mfkiwl/xrpcam-hardware-zynq/hardware/zynq_board.kicad_pcb

## KiCad design hardware/zynq_board.kicad_pcb (2018-11-18)

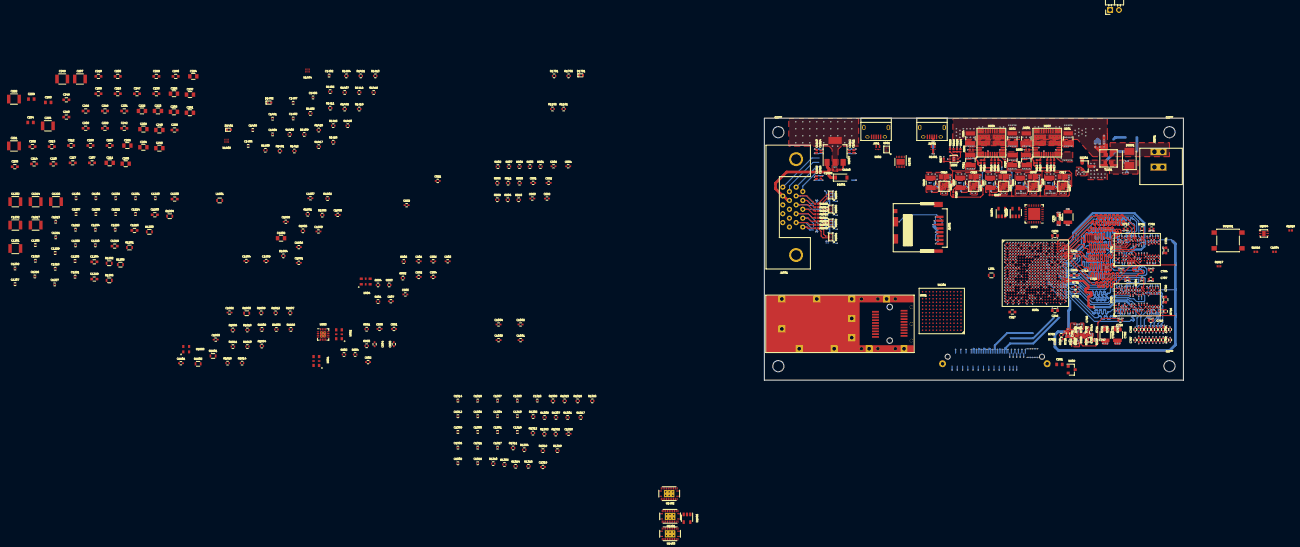
[picture p1: board zynq_board.kicad_pcb from above]

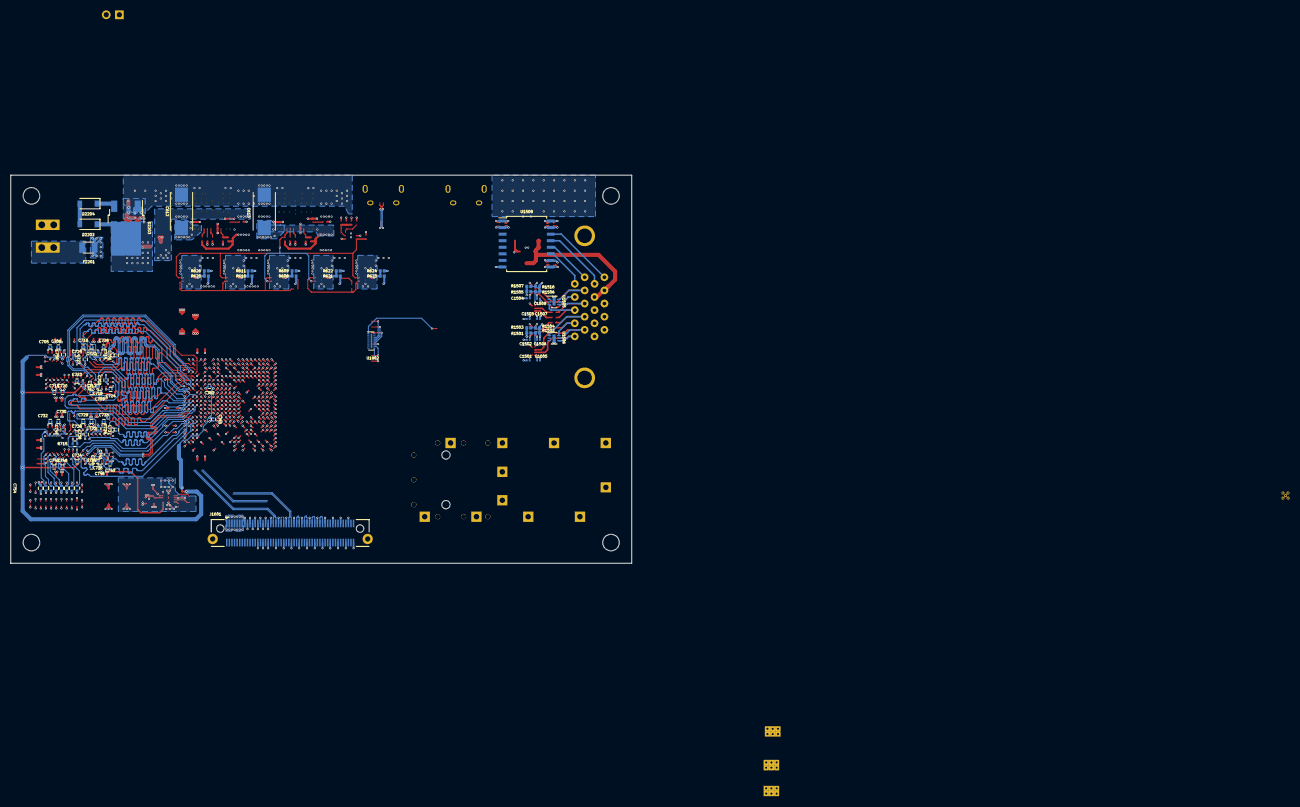
[picture p2: board zynq_board.kicad_pcb from below]

Board: 8 copper layers, 120.0 x 75.0 mm, 493 parts (86 on the bottom side), 429 nets.

Parts:
C201, C203, C234, C239: 47µF; C_0603_1608Metric
C204, C205, C206, C208, C211, C223, C224, C225, C226, C236, C237, C243, C245, C251, C256: 4.7µF; C_0805
C207, C221, C222, C232, C248, C254: 100µF; C_1210
C209, C210, C212, C213, C214, C215, C216, C217, C218, C219, C220, C227, C228, C229, C230, C231, C233, C235, C238, C240, C241, C242, C244, C246, C247, C249, C250, C252, C253, C257, C258: 0.47µF; C_0603
C255: 10μF; C_0603
C501, C502, C505, C506: 0.1uF; C_0402
C503, C504: 22uF; C_0402
C601, C602, C603, C604: 10uF 25V; C_1210_3225Metric
C605, C606, C615, C616, C617: 10uF; C_0805_2012Metric
C607, C608, C609, C618, C619, C620: 47uF 6.3V; C_1210_3225Metric
C610, C611: 100uF 6.3V; C_1210_3225Metric
C612, C613: 220uF 6.3V 15mΩ; C7343-31_KEMET-D_10.22x5.6mm
C614, C1804: 1nF; C_0402_1005Metric
C621, C622: 1 µF 6.3 V; C_0402
C701, C728: 10 µF; C_0603
C702, C704, C707, C710, C714, C717, C719, C722: 1µF; C_0402
C703, C705, C706, C708, C709, C711, C712, C713, C715, C716, C718, C720, C721, C723, C724, C725, C726, C727, C729, C730, C731, C732, C733, C734, C735, C736, C737, C738, C739, C740, C741, C742, C743, C744, C746, C748, C749, C1205, C1206, C1207, C1208, C1209, C1210, C1211, C1212, C1213, C1216, C1218, C1220, C1221, C1222, C1223, C1224, C1225, C1227, C1229, C1230, C1231, C1234, C1235, C1236, C1237, C1238, C1301, C1302, C1303, C1304, C1305, C1306, C1307, C1308, C1309, C1310, C1311, C1312, C1313, C1314, C1315, C1316, C1317, C1318, C1401, C1402, C1403, C1404, C1405, C1406, C1407, C1408: 100 nF; C_0201
C745, C756, C761, C762: 0.01µF; C_0201
C747, C750: 10µF; C_0603
C751: 0.22µF; C_0402
C752, C753, C1201, C1202, C1214, C1217, C1226, C1232: 100 µF; C_1210
C754, C755: 4,7 µF; C_0402
C757, C758, C759, C760: 10 nF; C_0201
C801, C802, C803, C804, C902, C904, C905, C906, C907: 100n; C_0402
C805: 1u; C_0402
C901, C903: 2u2; C_0402
C1001, C1002, C1003, C1004: C_Small; C_0402
C1203, C1204, C1215, C1219, C1228, C1233: 4,7 µF; C_0603
C1319, C1320: DNP; C_0402
C1501, C1502, C1503, C1504, C1505, C1506, C1507, C1508, C1512, C1514, C1515: 100 nF; C_0201_0603Metric
C1509, C1510, C1511, C1513, C1516: 1 µF 6,3 V; C_0402_1005Metric
C1801, C1802, C1803, C1904, C1907, C1908, C1909: 100 nF; C_0402
C1901, C1906: 10 nF; C_0402
C1902: 4,7 µF; C_0805
C1903, C1905: 47 pF; C_0402
D1401, D1402: LED_Small; LED_0402
D1501, D2204: PMEG3020EGWX; D_SOD-123
D1701: LED; LED_0402
D2201: P0220SCMCLRP; DO-214AA
D2202: 15 V; D_SOD-123
D2203: TN1515-600B-TR; TO-252-2
F2201: Fuse; Fuse_SMD1206_Reflow
J901, J1901: USB_OTG; USB_Micro-B
J1501: MDR20; Conn_MDR20
J1601: LSHM-150-xxx-x-DV-A-S
J1702: Conn_01x02; Pin_Header_Angled_1x02_Pitch2.54mm
J1801: DM3CS
J2201: Conn_01x02; WAGO-890-802
L201: 120 Ohm @ 1Mhz; L_0603
L1901: 600R@100MHz; L_0603
Q2201: DMP3056L; SOT-23
R501, R503, R504, R506, R507, R508, R509, R903, R1401, R1402, R1403, R1404, R1405, R1406, R1407, R1408, R1409, R1901: 10k; R_0402
R502, R505, R1301, R1303, R1305, R1307, R1309, R1313, R1317, R1701, R1804, R1807, R1809, R1810, R1812: DNP; R_0402
R510, R511, R904, R1418, R1419, R1420, R1421: 1k; R_0402
R601, R602, R603: 31.6k; R_0402_1005Metric
R604: 3.01k; R_0402_1005Metric
R605: 40.2k; R_0402_1005Metric
R606: 124k; R_0402_1005Metric
R607, R616, R617, R620, R627, R1819: 100k; R_0402_1005Metric
R608: 187k 1%; R_0402_1005Metric
R609, R611, R624: 150k 1%; R_0402_1005Metric
R610: 470k 1%; R_0402_1005Metric
R612, R614, R1501, R1503, R1506, R1516: 10k; R_0402_1005Metric
R613: 1.37k; R_0402_1005Metric
R615: 15k; R_0402_1005Metric
R618, R1817: 3M; R_0402_1005Metric
R619: 270k; R_0402_1005Metric
R621: 30k 1%; R_0402_1005Metric
R622: 120k 1%; R_0402_1005Metric
R623: 75k 1%; R_0402_1005Metric
R625: 68k 1%; R_0402_1005Metric
R626: 100k 1%; R_0402_1005Metric
R628: 43k; R_0402_1005Metric
R701, R704: 240Ω; R_0402
R702, R703: 10kΩ; R_0402
R705, R706, R707, R708, R709, R710, R711, R712, R713, R714, R717, R718, R719, R720, R721, R722, R723, R724, R725, R726, R727, R728, R729, R730: 40.2Ω; R_0402
R715, R731, R732: 80.6Ω; R_0402
R716: 4.7 kΩ; R_0402
R801, R802, R803, R901, R1302, R1304, R1306, R1308, R1310: 0; R_0402
R804, R1314: 100; R_0402
R902, R1904, R1905: 100k; R_0402
R905: 8.06k; R_0402
R1101, R1102: 4k7; R_0402
R1201, R1202, R1203, R1204, R1205, R1206: 0; R_0603
R1311, R1315, R1316, R1318, R1319, R1320: R; R_0402
R1312: 2k; R_0402
R1410, R1411: 420; R_0402
R1412, R1413, R1414, R1415: 300; R_0402
R1416, R1417: 200k; R_0402
R1502, R1504, R1505, R1507: DNP; R_0402_1005Metric
R1508, R1509, R1510, R1511, R1512, R1513, R1514, R1515: 270; R_0402_1005Metric
R1702: 430; R_0402
R1801: DNP; R_0603
R1802, R1803: 4k7; R_0603
R1805, R1806, R1808, R1811, R1813, R1814, R1815: 20k; R_0402
R1816: 40,2; R_0402
R1818: 560k; R_0402_1005Metric
R1902, R1903: 27; R_0402
SW1801: SW_Push; SW_SPST_PTS645
T2201: 500 Ohm@100 MHz; DLW5BTM_5.00x5.00mm
U201: xc7z030sbg485; SBG485_22x22_19.0x19.0mm_Pitch0.8mm
U501: SFPP_CONN; SFP+_Connector_with_Cage
U601, U602, U605, U606, U607: TPS8208x; TI_MicroSiP_2.9x3.1mm
U603, U604: TPSM84424; TI_QFM-24_MOL0024A
U608, U1804: TPS3808G01; Texas_S-PWSON-N6
U609: MCP1700-2502E_SOT23; SOT-23
U701, U703: MT41K128M8; BGA-96_2x3x16_9.0x13.0mm_Pitch0.8mm
U702: TPS51206; TI_PWSON-N10_2.0x2.0mm
U801, U802: DIFF_OSC; VDFN_3.2x2.5mm
U803: SI53340; QFN-16-1EP_3x3mm_Pitch0.5mm_ThermalVias
U901: NX5P3090; WLCSP12_3x4_1.35x1.65mm_Pitch0.4mm
U902, U1901: SMP1255PUTG; SMC_MicroDFN_1.8x2.0mm_0.4mm_Pitch
U903: USB3320; QFN-32-1EP_5x5mm_Pitch0.5mm
U904: OSC; VDFN_3.2x2.5mm
U1201: TLK10031; TI-CTR_FCBGA_N144_12x12_13x13mm_Pitch1.0mm
U1401, U1402, U1403: SN74AXC8T245; VQFN-24
U1404, U1405: LSF0102; TI-DQE_PX2SON-N8_1.4x1mm_0.35mm_Pitch
U1501, U1502, U1503, U1504: SN74LVC2T45; DSBGA_2x4_0.918x1.918mm_Pitch0.5mm
U1505, U1506: DMF05LCFLP; DFN-6-1EP_2x2mm_Pitch0.5mm
U1507: TC1262-33; SOT-223
U1508: MAX14854; SOIC-16W_7.5x10.3mm_Pitch1.27mm
U1801: CAT24C02TDI-GT3; SOT-23-5
U1802: EMIF06-MSD02N16; µQFN-16L
U1803: 33.333MHZ; ASDMB_2.5x2.0mm_1.65mm_pitch
U1902: FT234XD; DFN-12-1EP_3x3mm_Pitch0.45mm
U1903, U1904: SN74LV1T126; SOT-23-5

Connections:
+1V0: C205.1, C207.1, C208.1, C210.1, C211.1, C213.1, C215.1, C216.1, C218.1, C219.1, C220.1, C221.1, C224.1, C227.1, C230.1, C610.1, C611.1, C613.1, R614.1, R616.1, R1201.1, R1202.1, R1204.1, R1206.1, U201.G15, U201.H12, U201.H14, U201.J9, U201.J11, U201.J13, U201.J15, U201.K10, U201.L9, U201.L15, U201.M10, U201.N9, U201.N15, U201.P10, U201.R9, U201.R15, U604.1, U604.8
+1V0_MGT: C618.1, R620.1, R621.1, U201.U4, U201.U6, U201.U8, U201.W5, U201.W9, U605.8
+1V2_MGT: C619.1, R623.1, U201.AA2, U201.AA4, U201.AA8, U201.AB1, U201.AB6, U201.V7, U201.Y7, U606.8
+5V: C602.1, C604.1, C605.1, C606.1, C609.1, C612.1, C615.1, C616.1, C617.1, C749.1, C902.1, D1501.2, J1601.1, J1601.3, J1601.5, J1601.7, J1601.9, J1601.11, J1601.13, R612.1, R617.1, R618.1, R628.2, R702.2, R703.1, U601.3, U601.4, U602.3, U602.4, U603.1, U603.8, U604.11, U604.22, U605.3, U605.4, U606.3, U606.4, U607.3, U607.4, U608.1, U702.10, U901.B1, U901.B2, U901.C1
/10G Clock/125_00_MHZ_N: C1003.2, U801.5
/10G Clock/125_00_MHZ_P: C1004.2, U801.4
/10G Clock/156_25_MHZ_0_N: C1001.2, U803.10
/10G Clock/156_25_MHZ_0_P: C1002.2, U803.9
/10G Clock/156_25_MHZ_1_N: C1310.2, U803.12
/10G Clock/156_25_MHZ_1_P: C1305.2, U803.11
/BUTTON0: J1702.1, R1701.2, U201.D6
/Camera Connector/CAM_CLK_0_N: J1601.96, U201.Y15
/Camera Connector/CAM_CLK_0_P: J1601.98, U201.Y14
/Camera Connector/CAM_CLK_1_N: J1601.97, U201.Y19
/Camera Connector/CAM_CLK_1_P: J1601.99, U201.Y18
/Camera Connector/CAM_CTRL_0_N: J1601.36, U201.W16
/Camera Connector/CAM_CTRL_0_P: J1601.38, U201.V16
/Camera Connector/CAM_CTRL_1_N: J1601.63, U201.Y17
/Camera Connector/CAM_CTRL_1_P: J1601.61, U201.W17
/Camera Connector/D0_N: J1601.43, U201.V14
/Camera Connector/D0_P: J1601.45, U201.V13
/Camera Connector/D1_N: J1601.42, U201.W15
/Camera Connector/D1_P: J1601.44, U201.V15
/Camera Connector/D2_N: J1601.54, U201.W13
/Camera Connector/D2_P: J1601.56, U201.W12
/Camera Connector/D3_N: J1601.48, U201.W11
/Camera Connector/D3_P: J1601.50, U201.V11
/Camera Connector/D4_N: J1601.49, U201.U12
/Camera Connector/D4_P: J1601.51, U201.U11
/Camera Connector/D5_N: J1601.55, U201.AB11
/Camera Connector/D5_P: J1601.57, U201.AA11
/Camera Connector/D6_N: J1601.78, U201.AB12
/Camera Connector/D6_P: J1601.80, U201.AA12
/Camera Connector/D7_N: J1601.60, U201.AB14
/Camera Connector/D7_P: J1601.62, U201.AB13
/Camera Connector/D8_N: J1601.72, U201.Y13
/Camera Connector/D8_P: J1601.74, U201.Y12
/Camera Connector/D9_N: J1601.84, U201.AB22
/Camera Connector/D9_P: J1601.86, U201.AB21
/Camera Connector/D10_N: J1601.67, U201.AB19
/Camera Connector/D10_P: J1601.69, U201.AB18
/Camera Connector/D11_N: J1601.73, U201.AB17
/Camera Connector/D11_P: J1601.75, U201.AB16
/Camera Connector/D12_N: J1601.90, U201.AA20
/Camera Connector/D12_P: J1601.92, U201.AA19
/Camera Connector/D13_N: J1601.79, U201.V19
/Camera Connector/D13_P: J1601.81, U201.U19
/Camera Connector/D14_N: J1601.91, U201.W18
/Camera Connector/D14_P: J1601.93, U201.V18
/Camera Connector/D15_N: J1601.85, U201.U18
/Camera Connector/D15_P: J1601.87, U201.U17
/Camera Connector/FRAME_REQ_0: J1601.24, U1402.17
/Camera Connector/FRAME_REQ_1: J1601.18, U1402.20
/Camera Connector/LVDS_CLK0_N: J1601.39, U201.AA15
/Camera Connector/LVDS_CLK0_P: J1601.37, U201.AA14
/Camera Connector/LVDS_CLK1_N: J1601.66, U201.AA17
/Camera Connector/LVDS_CLK1_P: J1601.68, U201.AA16
/Camera Connector/T_EXP1_0: J1601.22, U1402.18
/Camera Connector/T_EXP1_1: J1601.16, U1402.21
/Camera Connector/T_EXP2_0: J1601.20, U1402.19
/Camera Connector/T_EXP2_1: J1601.14, U1401.14
/DDR/A0: R724.2, U201.M19, U701.N3, U703.N3
/DDR/A1: R711.2, U201.M18, U701.P7, U703.P7
/DDR/A2: R723.2, U201.K19, U701.P3, U703.P3
/DDR/A3: R710.2, U201.L19, U701.N2, U703.N2
/DDR/A4: R722.2, U201.K17, U701.P8, U703.P8
/DDR/A5: R709.2, U201.K18, U701.P2, U703.P2
/DDR/A6: R721.2, U201.J16, U701.R8, U703.R8
/DDR/A7: R708.2, U201.J17, U701.R2, U703.R2
/DDR/A8: R720.2, U201.J18, U701.T8, U703.T8
/DDR/A9: R707.2, U201.H18, U701.R3, U703.R3
/DDR/A10: R719.2, U201.J20, U701.L7, U703.L7
/DDR/A11: R706.2, U201.G18, U701.R7, U703.R7
/DDR/A12: R718.2, U201.H19, U701.N7, U703.N7
/DDR/A13: R705.2, U201.F19, U701.T3, U703.T3
/DDR/A14: R717.2, U201.G19, U701.T7, U703.T7
/DDR/DDR_BA0: R730.2, U201.L16, U701.M2, U703.M2
/DDR/DDR_BA1: R714.2, U201.L17, U701.N8, U703.N8
/DDR/DDR_BA2: R729.2, U201.M17, U701.M3, U703.M3
/DDR/DDR_CKE: R727.2, U201.T19, U701.K9, U703.K9
/DDR/DDR_CLK_N: R715.1, U201.N18, U701.K7, U703.K7
/DDR/DDR_CLK_P: R715.2, U201.N19, U701.J7, U703.J7
/DDR/DDR_DM0: U201.B22, U701.E7
/DDR/DDR_DM1: U201.H20, U701.D3
/DDR/DDR_DM2: U201.P22, U703.E7
/DDR/DDR_DM3: U201.AA21, U703.D3
/DDR/DDR_DQS0_N: U201.D21, U701.G3
/DDR/DDR_DQS0_P: U201.C21, U701.F3
/DDR/DDR_DQS1_N: U201.J21, U701.B7
/DDR/DDR_DQS1_P: U201.H21, U701.C7
/DDR/DDR_DQS2_N: U201.P21, U703.G3
/DDR/DDR_DQS2_P: U201.N21, U703.F3
/DDR/DDR_DQS3_N: U201.W21, U703.B7
/DDR/DDR_DQS3_P: U201.V21, U703.C7
/DDR/DDR_ODT: R728.2, U201.P18, U701.K1, U703.K1
/DDR/DQ0: U201.D22, U701.H7
/DDR/DQ1: U201.C20, U701.F7
/DDR/DQ2: U201.B21, U701.F8
/DDR/DQ3: U201.D20, U701.H8
/DDR/DQ4: U201.E20, U701.H3
/DDR/DQ5: U201.E22, U701.E3
/DDR/DQ6: U201.F21, U701.F2
/DDR/DQ7: U201.F22, U701.G2
/DDR/DQ8: U201.G21, U701.D7
/DDR/DQ9: U201.G22, U701.B8
/DDR/DQ10: U201.L22, U701.A3
/DDR/DQ11: U201.L21, U701.A2
/DDR/DQ12: U201.L20, U701.C3
/DDR/DQ13: U201.K22, U701.C2
/DDR/DQ14: U201.J22, U701.A7
/DDR/DQ15: U201.K20, U701.C8
/DDR/DQ16: U201.M22, U703.H8
/DDR/DQ17: U201.T20, U703.H3
/DDR/DQ18: U201.N20, U703.F8
/DDR/DQ19: U201.T22, U703.E3
/DDR/DQ20: U201.R20, U703.G2
/DDR/DQ21: U201.T21, U703.F2
/DDR/DQ22: U201.M21, U703.F7
/DDR/DQ23: U201.R22, U703.H7
/DDR/DQ24: U201.Y20, U703.C2
/DDR/DQ25: U201.U22, U703.D7
/DDR/DQ26: U201.AA22, U703.C3
/DDR/DQ27: U201.U21, U703.B8
/DDR/DQ28: U201.W22, U703.A7
/DDR/DQ29: U201.W20, U703.A3
/DDR/DQ30: U201.V20, U703.C8
/DDR/DQ31: U201.Y22, U703.A2
/DDR/VREF: C745.1, C751.1, C756.1, C761.1, C762.1, U201.H16, U201.P16, U701.H1, U701.M8, U702.6, U703.H1, U703.M8
/DDR/VTT: C750.2, C752.1, C753.1, C754.1, C755.1, C757.1, C758.1, C759.1, C760.1, R705.1, R706.1, R707.1, R708.1, R709.1, R710.1, R711.1, R712.1, R713.1, R714.1, R717.1, R718.1, R719.1, R720.1, R721.1, R722.1, R723.1, R724.1, R725.1, R726.1, R727.1, R728.1, R729.1, R730.1, U702.3, U702.5
/DDR/~DDR_CAS~: R725.2, U201.P20, U701.K3, U703.K3
/DDR/~DDR_CS~: R726.2, U201.P17, U701.L2, U703.L2
/DDR/~DDR_RAS~: R713.2, U201.R18, U701.J3, U703.J3
/DDR/~DDR_RESET~: R716.2, U201.F20, U701.T2, U703.T2
/DDR/~DDR_WE~: R712.2, U201.R19, U701.L3, U703.L3
/IMU_CLK: J1601.19, U201.A7
/IMU_EN_0: J1601.17, U201.B7
/IMU_EN_1: J1601.15, U201.B8
/IMU_FRAME_GPIO0: J1601.25, U201.J5
/IMU_INT1_GPIO1: J1601.27, U201.K5
/IMU_INT2_GPIO2: J1601.29, U201.L5
/IMU_MISO: J1601.23, U201.A6
/IMU_MOSI: J1601.21, U201.B6
/LED1: U201.E8, U1402.8
/LED2: U201.E7, U1402.9
/LS_OK_IN_A: U201.N1, U1201.B10
/LS_OK_OUT_A: U201.P1, U1201.D9
/Levelshifters/CAM0_CLK_REF: J1601.32, U1401.20
/Levelshifters/CAM1_CLK_REF: J1601.28, U1401.21
/Levelshifters/CAM_CLK0_REF_18: U201.B4, U1401.4
/Levelshifters/CAM_CLK1_REF_18: U201.D5, U1401.3
/Levelshifters/CAM_RESET: J1601.2, U1401.19
/Levelshifters/CAM_RESET_18: U201.B3, U1401.5
/Levelshifters/CAM_SCL: J1601.31, R1421.2, U1405.6
/Levelshifters/CAM_SCL_18: R1413.2, U201.A5, U1405.3
/Levelshifters/CAM_SDA: J1601.33, R1419.2, U1405.5
/Levelshifters/CAM_SDA_18: R1415.2, U201.A4, U1405.4
/Levelshifters/CAM_SPI_CLK: J1601.4, U1401.16
/Levelshifters/CAM_SPI_CLK_18: U201.C3, U1401.8
/Levelshifters/CAM_SPI_EN_0: J1601.8, U1401.17
/Levelshifters/CAM_SPI_EN_0_18: U201.A2, U1401.7
/Levelshifters/CAM_SPI_EN_1: J1601.6, U1401.18
/Levelshifters/CAM_SPI_EN_1_18: U201.B2, U1401.6
/Levelshifters/CAM_SPI_MISO: J1601.10, U1403.21
/Levelshifters/CAM_SPI_MISO_18: U201.B1, U1403.3
/Levelshifters/CAM_SPI_MOSI: J1601.12, U1401.15
/Levelshifters/CAM_SPI_MOSI_18: U201.A1, U1401.9
/Levelshifters/FRAME_REQ_0_18: U201.F1, U1402.7
/Levelshifters/FRAME_REQ_1_18: U201.D1, U1402.4
/Levelshifters/MODDET_18: U201.K2, U1403.6
/Levelshifters/RX_LOS_18: U201.J2, U1403.4
/Levelshifters/SFP_GPIO_18: U201.J1, U1403.7
/Levelshifters/SFP_SCL_18: R1412.2, U201.L1, U1404.3
/Levelshifters/SFP_SDA_18: R1414.2, U201.L2, U1404.4
/Levelshifters/TX_DISABLE_18: U201.M1, U1403.8
/Levelshifters/TX_FAULT_18: U201.M2, U1403.5
/Levelshifters/T_EXP1_0_18: U201.E2, U1402.6
/Levelshifters/T_EXP1_1_18: U201.D2, U1402.3
/Levelshifters/T_EXP2_0_18: U201.D3, U1402.5
/Levelshifters/T_EXP2_1_18: U201.C1, U1401.10
/MDC: U201.T1, U1201.J8
/MDIO: R1312.1, U201.T2, U1201.J7
/MODDET: R506.2, U501.6, U1403.18
/PG: R627.2, R1817.1, U201.B18, U602.2, U606.2, U607.2, U608.6
/PL: Bank 34/DE: U201.M3, U1508.6
/PL: Bank 34/RXD: U201.P3, U1508.3
/PL: Bank 34/TXD: U201.K3, U1508.5
/PL: Bank 34/~RE~: U201.N3, U1508.4
/PL: Bank 34/~SBA~: U201.J3, U1508.7
/PL: MGT/MGTX_RX_0_N: C1318.2, U201.AB7
/PL: MGT/MGTX_RX_0_P: C1314.2, U201.AA7
/PL: MGT/MGTX_RX_1_N: C1309.2, U201.Y8
/PL: MGT/MGTX_RX_1_P: C1304.2, U201.W8
/PL: MGT/MGTX_RX_2_N: C1317.2, U201.AB9
/PL: MGT/MGTX_RX_2_P: C1313.2, U201.AA9
/PL: MGT/MGTX_RX_3_N: C1308.2, U201.Y6
/PL: MGT/MGTX_RX_3_P: C1303.2, U201.W6
/PMIC/EN_1V0_MGT: R616.2, U601.1, U604.7, U605.1
/PMIC/EN_1V2_MGT: R620.2, U605.2, U606.1
/PMIC/EN_3V3: R607.2, U601.2, U602.1, U607.1
/PMIC/PG_5V: R617.2, U603.7, U604.10
/PRBSEN: U201.P2, U1201.B9
/Power/VCC_PLL: C255.1, C258.1, L201.2, U201.G13
/Processing System IO/BOOT_MODE[0]: R1806.2, R1807.1, U201.A20
/Processing System IO/BOOT_MODE[1]: R1810.2, R1811.1, U201.F17
/Processing System IO/BOOT_MODE[2]: R1808.2, R1809.1, U201.E19
/Processing System IO/BOOT_MODE[3]: R1812.2, R1813.1, U201.A21
/Processing System IO/BOOT_MODE[4]: R1804.2, R1805.1, U201.A19
/Processing System IO/CLK_33.33: R1816.2, U201.F16
/Processing System IO/PS_RESET: R1819.2, U201.C14, U1804.6
/Processing System IO/SCL: R1803.2, U201.A9, U1801.1
/Processing System IO/SDA: R1802.2, U201.E12, U1801.3
/Processing System IO/SDIO0_CD: J1801.9, U201.D11, U1802.1
/Processing System IO/SDIO0_CK: U201.E9, U1802.6
/Processing System IO/SDIO0_CMD: U201.C15, U1802.5
/Processing System IO/SDIO0_IO0: U201.D15, U1802.7
/Processing System IO/SDIO0_IO1: U201.B12, U1802.8
/Processing System IO/SDIO0_IO2: U201.E10, U1802.3
/Processing System IO/SDIO0_IO3: U201.B14, U1802.4
/Processing System IO/VMODE_0: R1814.1, U201.D18
/Processing System IO/VMODE_1: R1815.1, U201.E18
/RX_LOS: R503.2, U501.8, U1403.20
/SFP_GPIO: R510.1, R511.1, U1403.17
/SFP_SCL: R507.2, R1420.2, U501.5, U1404.6
/SFP_SDA: R508.2, R1418.2, U501.4, U1404.5
/ST: U201.R2, U1201.M9
/TLK10031 Power/DVDD: C1217.1, C1219.1, C1221.1, C1223.1, C1224.1, C1225.1, C1227.1, C1229.1, R1204.2, U1201.D7, U1201.E7, U1201.F7, U1201.G6, U1201.G8, U1201.H7
/TLK10031 Power/VDDA: C1201.1, C1203.1, C1205.1, C1207.1, C1209.1, C1211.1, C1212.1, C1213.1, R1201.2, U1201.D2, U1201.F2, U1201.F11, U1201.G2, U1201.G10, U1201.J2
/TLK10031 Power/VDDD: C1232.1, C1233.1, C1234.1, C1235.1, C1236.1, C1237.1, C1238.1, R1206.2, U1201.E6, U1201.E8, U1201.F6, U1201.H6, U1201.H8
/TLK10031 Power/VDDO: C1226.1, C1228.1, C1230.1, C1231.1, R1205.2, U1201.C7, U1201.K7
/TLK10031 Power/VDDRA: C1214.1, C1215.1, C1216.1, C1218.1, C1220.1, C1222.1, R1203.2, U1201.C3, U1201.E11, U1201.J11, U1201.K3
/TLK10031 Power/VDDT: C1202.1, C1204.1, C1206.1, C1208.1, C1210.1, R1202.2, U1201.F4, U1201.F9, U1201.G4
/TLK10031/HSRXA_N: U501.12, U1201.A12
/TLK10031/HSRXA_P: U501.13, U1201.B12
/TLK10031/HSTXA_N: U501.19, U1201.E12
/TLK10031/HSTXA_P: U501.18, U1201.D12
/TLK10031/INA0_N: C1316.1, U1201.A3
/TLK10031/INA0_P: C1312.1, U1201.A4
/TLK10031/INA1_N: C1307.1, U1201.B1
/TLK10031/INA1_P: C1302.1, U1201.A1
/TLK10031/INA2_N: C1315.1, U1201.C2
/TLK10031/INA2_P: C1311.1, U1201.B2
/TLK10031/INA3_N: C1306.1, U1201.E1
/TLK10031/INA3_P: C1301.1, U1201.D1
/TLK10031/INA[0]_N: C1316.2, U201.AB3
/TLK10031/INA[0]_P: C1312.2, U201.AA3
/TLK10031/INA[1]_N: C1307.2, U201.Y4
/TLK10031/INA[1]_P: C1302.2, U201.W4
/TLK10031/INA[2]_N: C1315.2, U201.AB5
/TLK10031/INA[2]_P: C1311.2, U201.AA5
/TLK10031/INA[3]_N: C1306.2, U201.Y2
/TLK10031/INA[3]_P: C1301.2, U201.W2
/TLK10031/OUTA0_N: C1318.1, U1201.A7
/TLK10031/OUTA0_P: C1314.1, U1201.A6
/TLK10031/OUTA1_N: C1309.1, U1201.B6
/TLK10031/OUTA1_P: C1304.1, U1201.B5
/TLK10031/OUTA2_N: C1317.1, U1201.C5
/TLK10031/OUTA2_P: C1313.1, U1201.C4
/TLK10031/OUTA3_N: C1308.1, U1201.E3
/TLK10031/OUTA3_P: C1303.1, U1201.F3
/TRIG_IN_0: U201.H1, U1501.B1
/TRIG_IN_1: U201.G2, U1501.C1
/TRIG_IN_2: U201.G1, U1502.B1
/TRIG_IN_3: U201.F2, U1502.C1
/TRIG_OUT_0: U201.H4, U1503.B1
/TRIG_OUT_1: U201.G3, U1503.C1
/TRIG_OUT_2: U201.F4, U1504.B1
/TRIG_OUT_3: U201.E3, U1504.C1
/TX_DISABLE: U501.3, U1403.16
/TX_FAULT: R509.2, U501.2, U1403.19
/Triggerbus/3.3V_OUT: C1510.1, J1501.15, J1501.16, U1507.3
/Triggerbus/5V_OUT: C1509.1, D1501.1, J1501.17, J1501.18, U1507.1
/Triggerbus/A: J1501.20, U1508.14
/Triggerbus/B: J1501.19, U1508.13
/Triggerbus/EXT_TRIG_IN_0: J1501.1, R1508.2, U1506.4
/Triggerbus/EXT_TRIG_IN_1: J1501.2, R1509.1, U1506.5
/Triggerbus/EXT_TRIG_IN_2: J1501.3, R1510.2, U1506.6
/Triggerbus/EXT_TRIG_IN_3: J1501.4, R1511.1, U1506.1
/Triggerbus/EXT_TRIG_OUT_0: J1501.5, R1512.2, U1505.3
/Triggerbus/EXT_TRIG_OUT_1: J1501.6, R1513.1, U1505.4
/Triggerbus/EXT_TRIG_OUT_2: J1501.7, R1514.2, U1505.5
/Triggerbus/EXT_TRIG_OUT_3: J1501.8, R1515.1, U1505.6
/Triggerbus/Y: J1501.9, U1508.11
/Triggerbus/Z: J1501.10, U1508.12
/USB-UART/USB_UART_N: C1905.1, J1901.2, R1903.2, U1901.3
/USB-UART/USB_UART_P: C1903.1, J1901.3, R1902.1, U1901.2
/USB-UART/USB_UART_RX: U1902.10, U1904.4
/USB-UART/USB_UART_TX: U1902.7, U1903.2
/USB-UART/VBUS: C1902.1, C1904.1, L1901.2, R1901.1, U1901.1, U1902.4
/USB-UART/VCCIO: C1907.1, C1909.1, R1904.2, U1902.3, U1902.9, U1903.1, U1904.5
/USB/CLK: U201.A14, U903.1
/USB/DATA0: U201.C16, U903.3
/USB/DATA1: U201.G11, U903.4
/USB/DATA2: U201.B11, U903.5
/USB/DATA3: U201.F9, U903.6
/USB/DATA4: U201.A11, U903.7
/USB/DATA5: U201.B9, U903.9
/USB/DATA6: U201.F10, U903.10
/USB/DATA7: U201.C10, U903.13
/USB/DIR: U201.E15, U903.31
/USB/NXT: U201.F14, U903.2
/USB/STP: U201.A12, U903.29
/USB/VBUS_FAULT: R903.2, U901.A2
/V_IN: C601.1, C603.1, Q2201.2, U603.11, U603.22
/~TLK_RESET~: U201.U1, U1201.H5
GND: C201.2, C203.2, C204.2, C205.2, C206.2, C207.2, C208.2, C209.2, C210.2, C211.2, C212.2, C213.2, C214.2, C215.2, C216.2, C217.2, C218.2, C219.2, C220.2, C221.2, C222.2, C223.2, C224.2, C225.2, C226.2, C227.2, C228.2, C229.2, C230.2, C231.2, C232.2, C233.2, C234.2, C235.2, C236.2, C237.2, C238.2, C239.2, C240.2, C241.2, C242.2, C243.2, C244.2, C245.2, C246.2, C247.2, C248.2, C249.2, C250.2, C251.2, C252.2, C253.2, C254.2, C255.2, C256.2, C257.2, C258.2, C501.2, C502.2, C503.2, C504.2, C505.2, C506.2, C601.2, C602.2, C603.2, C604.2, C605.2, C606.2, C607.2, C608.2, C609.2, C610.2, C611.2, C612.2, C613.2, C614.2, C615.2, C616.2, C617.2, C618.2, C619.2, C620.2, C621.2, C622.2, C701.2, C702.2, C703.2, C704.2, C705.2, C706.2, C707.2, C708.2, C709.2, C710.2, C711.2, C712.2, C713.2, C714.2, C715.2, C716.2, C717.2, C718.2, C719.2, C720.2, C721.2, C722.2, C723.2, C724.2, C725.2, C726.2, C727.2, C728.2, C729.2, C730.2, C731.2, C732.2, C733.2, C734.2, C735.2, C736.2, C737.2, C738.2, C739.2, C740.2, C741.2, C742.2, C743.2, C744.2, C745.2, C746.2, C747.2, C748.2, C749.2, C750.1, C751.2, C752.2, C753.2, C754.2, C755.2, C756.2, C757.2, C758.2, C759.2, C760.2, C761.2, C762.2, C801.2, C802.2, C805.2, C901.1, C902.2, C903.2, C904.2, C905.2, C906.2, C907.2, C1201.2, C1202.2, C1203.2, C1204.2, C1205.2, C1206.2, C1207.2, C1208.2, C1209.2, C1210.2, C1211.2, C1212.2, C1213.2, C1214.2, C1215.2, C1216.2, C1217.2, C1218.2, C1219.2, C1220.2, C1221.2, C1222.2, C1223.2, C1224.2, C1225.2, C1226.2, C1227.2, C1228.2, C1229.2, C1230.2, C1231.2, C1232.2, C1233.2, C1234.2, C1235.2, C1236.2, C1237.2, C1238.2, C1401.2, C1402.2, C1403.2, C1404.2, C1405.2, C1406.2, C1407.1, C1408.1, C1501.1, C1502.1, C1503.1, C1504.1, C1505.1, C1506.1, C1507.1, C1508.1, C1509.2, C1510.2, C1511.2, C1512.2, C1513.2, C1514.2, C1515.2, C1516.2, C1801.1, C1802.1, C1803.1, C1804.2, C1901.2, C1902.2, C1903.2, C1904.2, C1905.2, C1906.2, C1907.2, C1908.2, C1909.2, D1401.1, D1402.1, D1701.1, D2203.1, J901.5, J1501.11, J1501.12, J1501.13, J1501.14, J1601.26, J1601.30, J1601.34, J1601.35, J1601.40, J1601.41, J1601.46, J1601.47, J1601.52, J1601.53, J1601.58, J1601.59, J1601.64, J1601.65, J1601.70, J1601.71, J1601.76, J1601.77, J1601.82, J1601.83, J1601.88, J1601.89, J1601.94, J1601.95, J1601.100, J1601.101, J1702.2, J1801.6, J1801.10, J1901.5, J1901.6, Q2201.1, R502.2, R505.2, R601.1, R602.1, R603.2, R604.2, R605.2, R606.2, R609.2, R611.2, R619.2, R622.2, R624.2, R626.2, R701.2, R704.2, R716.1, R732.1, R801.2, R802.2, R901.2, R902.1, R905.1, R1302.2, R1304.2, R1306.2, R1308.2, R1310.2, R1314.2, R1315.1, R1316.1, R1318.1, R1319.1, R1320.1, R1402.1, R1403.1, R1405.1, R1406.1, R1407.1, R1409.1, R1502.2, R1504.2, R1506.2, R1516.2, R1805.2, R1807.2, R1809.2, R1811.2, R1813.2, R1814.2, R1815.2, R1818.2, R1904.1, R1905.2, SW1801.1, T2201.4, U201.A8, U201.A18, U201.AA1, U201.AA6, U201.AA10, U201.AA18, U201.AB2, U201.AB4, U201.AB8, U201.AB10, U201.AB15, U201.B5, U201.B15, U201.C2, U201.C12, U201.C22, U201.D9, U201.D19, U201.E6, U201.E16, U201.F3, U201.F13, U201.G10, U201.G12, U201.G14, U201.G20, U201.H7, U201.H13, U201.H15, U201.H17, U201.J4, U201.J10, U201.J12, U201.J14, U201.K1, U201.K9, U201.K11, U201.K13, U201.K15, U201.K21, U201.L8, U201.L10, U201.L11, U201.L12, U201.L14, U201.L18, U201.M5, U201.M9, U201.M11, U201.M12, U201.M13, U201.M15, U201.N2, U201.N10, U201.N11, U201.N12, U201.N14, U201.N22, U201.P9, U201.P11, U201.P13, U201.P15, U201.P19, U201.R6, U201.R10, U201.R12, U201.R14, U201.R16, U201.T3, U201.T4, U201.T5, U201.T6, U201.T7, U201.T9, U201.T13, U201.U3, U201.U10, U201.U20, U201.V1, U201.V2, U201.V3, U201.V4, U201.V6, U201.V8, U201.V17, U201.W1, U201.W7, U201.W10, U201.W14, U201.Y1, U201.Y3, U201.Y5, U201.Y9, U201.Y10, U201.Y11, U201.Y21, U501.1, U501.10, U501.11, U501.14, U501.17, U501.20, U601.5, U601.6, U601.PAD, U602.5, U602.6, U602.PAD, U603.12, U603.13, U603.14, U603.15, U603.18, U603.19, U603.20, U603.21, U604.12, U604.13, U604.14, U604.15, U604.18, U604.19, U604.20, U604.21, U605.5, U605.6, U605.PAD, U606.5, U606.6, U606.PAD, U607.5, U607.6, U607.PAD, U608.5, U608.7, U609.1, U701.A9, U701.B1, U701.B3, U701.B9, U701.D1, U701.D8, U701.E1, U701.E2, U701.E8, U701.F9, U701.G1, U701.G8, U701.G9, U701.J2, U701.J8, U701.M1, U701.M9, U701.P1, U701.P9, U701.T1, U701.T9, U702.4, U702.8, U702.PAD, U703.A9, U703.B1, U703.B3, U703.B9, U703.D1, U703.D8, U703.E1, U703.E2, U703.E8, U703.F9, U703.G1, U703.G8, U703.G9, U703.J2, U703.J8, U703.M1, U703.M9, U703.P1, U703.P9, U703.T1, U703.T9, U801.3, U802.3, U803.1, U901.B3, U901.C3, U901.D3, U902.5, U902.6, U903.8, U903.14, U904.2, U1201.A2, U1201.A5, U1201.A11, U1201.B3, U1201.B4, U1201.B7, U1201.B11, U1201.C1, U1201.C6, U1201.C12, U1201.D3, U1201.D5, U1201.D10, U1201.D11, U1201.E2, U1201.E4, U1201.E10, U1201.F1, U1201.F5, U1201.F8, U1201.F10, U1201.F12, U1201.G1, U1201.G3, U1201.G5, U1201.G7, U1201.G11, U1201.H1, U1201.H2, U1201.H3, U1201.H4, U1201.H11, U1201.J1, U1201.J3, U1201.J5, U1201.J12, U1201.K1, U1201.K2, U1201.K4, U1201.K5, U1201.K6, U1201.K11, U1201.L1, U1201.L2, U1201.L3, U1201.L4, U1201.L5, U1201.L6, U1201.L7, U1201.L11, U1201.M1, U1201.M2, U1201.M3, U1201.M4, U1201.M5, U1201.M6, U1201.M7, U1201.M12, U1401.12, U1401.13, U1402.12, U1402.13, U1403.12, U1403.13, U1404.1, U1405.1, U1501.D1, U1502.D1, U1503.D1, U1504.D1, U1505.7, U1506.7, U1507.2, U1507.4, U1508.2, U1508.8, U1508.9, U1508.15, U1801.2, U1802.PAD, U1803.2, U1804.5, U1804.7, U1901.5, U1901.6, U1902.5, U1902.13, U1903.3, U1904.3
unnamed: C503.1, C505.1, U501.15
unnamed: C504.1, C506.1, U501.16
unnamed: C614.1, R618.2, R619.1, U608.2
unnamed: C803.1, R804.1, U803.6
unnamed: C803.2, U802.4
unnamed: C804.1, R804.2, U803.7
unnamed: C804.2, U802.5
unnamed: C901.2, J901.1, R904.2, U901.C2, U901.D1, U901.D2, U902.1
unnamed: C1001.1, U201.V9
unnamed: C1002.1, U201.U9
unnamed: C1003.1, U201.V5
unnamed: C1004.1, U201.U5
unnamed: C1305.1, U1201.M10
unnamed: C1310.1, U1201.M11
unnamed: C1319.1, U1201.C9
unnamed: C1319.2, R1313.2
unnamed: C1320.1, U1201.C10
unnamed: C1320.2, R1313.1
unnamed: C1407.2, R1416.2, U1404.7, U1404.8
unnamed: C1408.2, R1417.2, U1405.7, U1405.8
unnamed: C1513.1, C1514.1, U1508.16
unnamed: C1804.1, R1817.2, R1818.1, U1804.2
unnamed: C1901.1, J1901.1, L1901.1
unnamed: C1906.1, R1901.2, U1902.2
unnamed: D1401.2, R1410.1
unnamed: D1402.2, R1411.1
unnamed: D1701.2, R1702.2
unnamed: D2201.1, F2201.1, T2201.2
unnamed: D2201.2, J2201.2, T2201.3
unnamed: D2202.1, D2203.2, Q2201.3, T2201.1
unnamed: D2202.2, D2204.2
unnamed: D2203.3, D2204.1
unnamed: F2201.2, J2201.1
unnamed: J901.2, U902.3, U903.19
unnamed: J901.3, U902.2, U903.18
unnamed: J901.4, U902.4, U903.23
unnamed: J901.6, R901.1
unnamed: R1320.2, U1201.D8
unnamed: J1801.1, U1802.14
unnamed: J1801.2, U1802.13
unnamed: J1801.3, U1802.12
unnamed: J1801.5, U1802.11
unnamed: J1801.7, U1802.10
unnamed: J1801.8, U1802.9
unnamed: J1901.4, U1901.4
unnamed: R501.2, R502.1, R510.2, U501.9
unnamed: R504.2, R505.1, R511.2, U501.7
unnamed: R601.2, U603.6
unnamed: R602.2, U604.6
unnamed: R603.1, U603.5
unnamed: R604.1, U604.5
unnamed: R605.1, U603.24
unnamed: R606.1, U604.24
unnamed: R608.2, R609.1, U601.7
unnamed: R610.2, R611.1, U602.7
unnamed: R612.2, R613.1, U603.2
unnamed: R613.2, U603.3, U603.9, U603.23
unnamed: R614.2, R615.1, U604.2
unnamed: R615.2, U604.3, U604.9, U604.23
unnamed: R621.2, R622.1, U605.7
unnamed: R623.2, R624.1, U606.7
unnamed: R625.2, R626.1, U607.7
unnamed: R628.1, U608.3
unnamed: R701.1, U701.L8
unnamed: R702.1, U702.7
unnamed: R703.2, U702.9
unnamed: R704.1, U703.L8
unnamed: R731.1, U201.M16
unnamed: R732.2, U201.N16
unnamed: R801.1, U803.3
unnamed: R802.1, U803.2
unnamed: R803.1, U803.4
unnamed: R902.2, U901.A3
unnamed: R904.1, U903.22
unnamed: R905.2, U903.24
unnamed: R1101.2, U201.T8
unnamed: R1102.2, U201.V10
unnamed: R1301.2, R1302.1, U1201.H10
unnamed: R1303.2, R1304.1, U1201.G9
unnamed: R1305.2, R1306.1, U1201.L9
unnamed: R1307.2, R1308.1, U1201.J6
unnamed: R1309.2, R1310.1, U1201.M8
unnamed: R1311.1, U1201.A8
unnamed: R1314.1, U1201.K9, U1201.K10
unnamed: R1315.2, R1317.2, U1201.L10
unnamed: R1316.2, U1201.J4
unnamed: R1318.2, U1201.L8
unnamed: R1319.2, U1201.J10
unnamed: R1401.2, U1401.2
unnamed: R1402.2, U1401.11
unnamed: R1403.2, U1401.22
unnamed: R1404.2, U1402.2
unnamed: R1405.2, U1402.11
unnamed: R1406.2, U1402.22
unnamed: R1407.2, U1403.2
unnamed: R1408.2, U1403.11
unnamed: R1409.2, U1403.22
unnamed: R1410.2, U1402.16
unnamed: R1411.2, U1402.15
unnamed: R1501.1, R1502.1, U1501.D2
unnamed: R1503.1, R1504.1, U1502.D2
unnamed: R1505.1, R1506.1, U1503.D2
unnamed: R1507.1, R1516.1, U1504.D2
unnamed: R1508.1, U1501.B2
unnamed: R1509.2, U1501.C2
unnamed: R1510.1, U1502.B2
unnamed: R1511.2, U1502.C2
unnamed: R1512.1, U1503.B2
unnamed: R1513.2, U1503.C2
unnamed: R1514.1, U1504.B2
unnamed: R1515.2, U1504.C2
unnamed: R1801.2, U1801.5
unnamed: R1816.1, U1803.3
unnamed: R1902.2, U1902.12
unnamed: R1903.1, U1902.1
unnamed: SW1801.2, U1804.4
unnamed: U901.A1, U903.17
unnamed: U903.26, U904.3
PS_UART_RX: U201.A16, U1903.4
PS_UART_TX: U201.E13, U1904.2
VCCO_13: C201.1, C204.1, C206.1, C209.1, C212.1, C214.1, C217.1, C622.1, U201.AA13, U201.AB20, U201.T18, U201.U15, U201.V12, U201.W19, U201.Y16, U609.2
VCCO_34: C203.1, C222.1, C223.1, C225.1, C226.1, C228.1, C229.1, C231.1, C233.1, C234.1, C235.1, C237.1, C239.1, C240.1, C242.1, C243.1, C245.1, C247.1, C249.1, C250.1, C252.1, C607.1, C904.1, C905.1, C907.1, C1401.1, C1402.1, C1403.1, C1501.2, C1502.2, C1503.2, C1504.2, C1511.1, C1512.1, L201.1, R607.1, R608.1, R903.1, R1101.1, R1102.1, R1203.1, R1205.1, R1301.1, R1303.1, R1305.1, R1307.1, R1309.1, R1311.2, R1312.2, R1317.1, R1401.1, R1404.1, R1408.1, R1412.1, R1413.1, R1414.1, R1415.1, R1501.2, R1503.2, R1505.2, R1507.2, U201.A3, U201.C7, U201.D4, U201.E1, U201.F8, U201.G5, U201.H2, U201.K6, U201.K12, U201.K14, U201.L3, U201.L13, U201.M14, U201.N7, U201.N13, U201.P4, U201.P12, U201.P14, U201.R1, U201.R11, U201.R13, U201.T11, U201.T12, U201.T14, U201.T15, U601.8, U903.28, U903.30, U904.1, U904.4, U1401.1, U1402.1, U1403.1, U1404.2, U1405.2, U1501.A1, U1502.A1, U1503.A1, U1504.A1, U1508.1
VCCO_DDR: C232.1, C236.1, C238.1, C241.1, C244.1, C246.1, C620.1, C701.1, C702.1, C703.1, C704.1, C705.1, C706.1, C707.1, C708.1, C709.1, C710.1, C711.1, C712.1, C713.1, C714.1, C715.1, C716.1, C717.1, C718.1, C719.1, C720.1, C721.1, C722.1, C723.1, C724.1, C725.1, C726.1, C727.1, C728.1, C729.1, C730.1, C731.1, C732.1, C733.1, C734.1, C735.1, C736.1, C737.1, C738.1, C739.1, C740.1, C741.1, C742.1, C743.1, C744.1, C746.1, C747.1, C748.1, R625.1, R731.2, U201.E21, U201.F18, U201.H22, U201.J19, U201.K16, U201.M20, U201.N17, U201.R21, U201.V22, U607.8, U701.A1, U701.A8, U701.B2, U701.C1, U701.C9, U701.D2, U701.D9, U701.E9, U701.F1, U701.G7, U701.H2, U701.H9, U701.K2, U701.K8, U701.N1, U701.N9, U701.R1, U701.R9, U702.1, U702.2, U703.A1, U703.A8, U703.B2, U703.C1, U703.C9, U703.D2, U703.D9, U703.E9, U703.F1, U703.G7, U703.H2, U703.H9, U703.K2, U703.K8, U703.N1, U703.N9, U703.R1, U703.R9
VCCO_MIO0: C248.1, C251.1, C253.1, C254.1, C256.1, C257.1, C501.1, C502.1, C608.1, C621.1, C801.1, C802.1, C805.1, C903.1, C906.1, C1404.1, C1405.1, C1406.1, C1505.2, C1506.2, C1507.2, C1508.2, C1515.1, C1516.1, C1801.2, C1802.2, C1803.2, C1908.1, J1801.4, R501.1, R503.1, R504.1, R506.1, R507.1, R508.1, R509.1, R610.1, R627.1, R803.2, R1416.1, R1417.1, R1418.1, R1419.1, R1420.1, R1421.1, R1702.1, R1801.1, R1802.1, R1803.1, R1804.1, R1806.1, R1808.1, R1810.1, R1812.1, R1819.1, R1905.1, U201.A13, U201.B10, U201.B20, U201.C17, U201.D14, U201.E11, U602.8, U609.3, U801.6, U802.6, U803.5, U903.11, U903.20, U903.21, U903.32, U1401.23, U1401.24, U1402.23, U1402.24, U1403.23, U1403.24, U1501.A2, U1502.A2, U1503.A2, U1504.A2, U1508.10, U1801.4, U1802.15, U1802.16, U1803.1, U1803.4, U1804.1, U1903.5, U1904.1
