mfkiwl/xrpcam-hardware-zynq/(commit log)

2017-07-16 Add first batch of zynq datasheets / app notes
    [7_Series_Schematic_Review_Recommendations.xlsm]
2017-07-18 Add .gitignore with defaults for Linux/OS X/Kicad
2017-07-18 Add very rough schematics outline
    [AEL2005.sch, SFP_plus.sch, cam_conn.sch, ddr.sch, pmic.sch, zynq_MGT.sch, zynq_board.kicad_pcb, zynq_board.sch]
2017-07-25 Fill in 10GE interface (WIP)
    [10G_clock.sch, AEL2005.sch, AEL2005_power.sch, SFP_plus.sch, ddr.sch, pmic.sch, zynq_MGT.sch, zynq_board.sch]
2017-08-12 Add clocks for 10GE interface
    [10G_clock.sch, AEL2005.sch, AEL2005_power.sch, SFP_plus.sch, cam_conn.sch, ddr.sch, pmic.sch, zynq_MGT.sch]
2018-02-28 Status quo. WIP, no clue about the current status
    [10G_clock.sch, AEL2005.sch, AEL2005_power.sch, SFP_plus.sch, cam_conn.sch, ddr.sch, pmic.sch, zynq_MGT.sch]
2018-03-01 Add USB OTG interface
    [10G_clock.sch, AEL2005.sch, AEL2005_power.sch, SFP_plus.sch, cam_conn.sch, ddr.sch, pmic.sch, usb.sch]
2018-03-01 Connect memory to Zynq (WIP)
    [ddr.sch, zynq_board.sch, zynq_memory.sch]
2018-03-01 Add SD card and boot config (WIP)
    [sdcard.sch, zynq_board.sch, zynq_ps.sch]
2018-03-04 Fix direction for hierarchical pins
    [10G_clock.sch, AEL2005.sch, AEL2005_power.sch, SFP_plus.sch, cam_conn.sch, ddr.sch, pmic.sch, sdcard.sch]
2018-04-02 Add camera connector (WIP)
    [AEL2005.sch, cam_conn.sch, ddr.sch, pmic.sch, usb.sch, zynq_MGT.sch, zynq_board.sch, zynq_pl_13.sch]
2018-04-02 Add sheet for Zynq configuration bank 0
    [10G_clock.sch, AEL2005.sch, AEL2005_power.sch, SFP_plus.sch, cam_conn.sch, ddr.sch, sdcard.sch, usb.sch]
2018-04-04 Add symbol for TLK10031
    [10G_clock.sch, AEL2005.sch, AEL2005_power.sch, SFP_plus.sch, cam_conn.sch, ddr.sch, pmic.sch, sdcard.sch]
2018-11-18 Change 10GE interface phy to TLK10031
    Low speed signals are still missing. Low speed signals from sfp+ part now need to be connected to the fpga. The new Phy does not support i2c etc..
    Also changed KiCad Version to 4.0.7
    [10G_clock.sch, AEL2005.sch, AEL2005_power.sch, SFP_plus.sch, TLK10031.sch, TLK10031_Power.sch, cam_conn.sch, ddr.sch]
2018-11-18 Repaired USB OTG Connector
    [usb.sch]
2018-11-18 Changed TLK VDDO Voltage to 1V8 and corrected hierachical Pin direction
    [TLK10031.sch, zynq_board.sch]
2018-11-18 Added lshm-150 symbol
    [cam_conn.sch, zynq_board.sch]
2018-11-18 Almost drew 3,3 V lowspeed signals. Added Levelshifter Subschematic
    1,8 V Lowspeed Singals from 10 G Phy to FPGA are still missing.
    CAM_REF_CLK is not really low speed, maybe we should consider to use the lvds clock instead. I think it will work, since the signal should be realtive short(FPGA->Connector->Camerasensor[->Camerasensor2]). The levelshifter should also be fast enough.
    The i2c signals use simple N-Channel MOSTFET Transistors for Levelshifting
    [10G_clock.sch, Levelshifters.sch, SFP_plus.sch, TLK10031.sch, TLK10031_Power.sch, cam_conn.sch, ddr.sch, pmic.sch]
2018-11-18 Drew missing 10 G Phy Lowspeed Signals.
    Also moved the SFP+ Lowspeedsignals a bit to ease routing
    [SFP_plus.sch, TLK10031.sch, ddr.sch, pmic.sch, zynq_board.sch, zynq_pl_34.sch]
2018-11-18 Drew Camera Connector part.
    There is some space left on the connector. So it is still possible to add two lvds clocks for the Cameras
    [cam_conn.sch]
2018-11-18 Failed to save Levelshifter Symbol correctly...
    [Levelshifters.sch]
2018-11-18 KiCad does not support differential Busses yet. See https://bugs.launchpad.net/kicad/+bug/1419146. Fixed Data Lanes for Camera Connector.
    [10G_clock.sch, Levelshifters.sch, SFP_plus.sch, TLK10031.sch, TLK10031_Power.sch, cam_conn.sch, ddr.sch, sdcard.sch]
2018-11-18 Add all but 7030 supplies. Input protection, connector and some filtering is still missing.
    [pmic.sch]
2018-11-18 Added Symbol for Triggerbus Levelshifter. Triggerbus is WIP
    [triggerbus.sch]
2018-11-18 Added Second SPI Bus for IMUs to Cam Connector
    This SPI works on 1.8 V, don't confuse them. If this second SPI Bus shall be used for the Cam Chips, add Levelshifters on the Cam Board.
    Also reorderd some stuff around this connector, to ease routing
    [10G_clock.sch, Levelshifters.sch, SFP_plus.sch, TLK10031.sch, TLK10031_Power.sch, cam_conn.sch, ddr.sch, pmic.sch]
2018-11-18 Moved the FPGAs Memory Port to the DDR Sheet due KiCad 4.0.7 does not support Busses through hiearchical Labels
    [ddr.sch, zynq_board.sch, zynq_memory.sch]
2018-11-18 Triggerbus WIP.
    Also added more production data
    [10G_clock.sch, Levelshifters.sch, SFP_plus.sch, TLK10031.sch, TLK10031_Power.sch, cam_conn.sch, ddr.sch, pmic.sch]
2018-11-18 Finished Triggerbus and added GPIO Header to schematic.
    Also moved some Connections to the FPGA around to hopefully ease routing.
    [10G_clock.sch, Levelshifters.sch, SFP_plus.sch, TLK10031.sch, TLK10031_Power.sch, cam_conn.sch, ddr.sch, gpio.sch]
2018-11-18 Added Reset Button, Power LED, 2 Status LEDs and an external Button.
    [10G_clock.sch, Levelshifters.sch, SFP_plus.sch, TLK10031.sch, TLK10031_Power.sch, cam_conn.sch, ddr.sch, gpio.sch]
2018-11-18 Added Sdcard Slot.
    [10G_clock.sch, Levelshifters.sch, SFP_plus.sch, TLK10031.sch, TLK10031_Power.sch, cam_conn.sch, ddr.sch, gpio.sch]
2018-11-18 Added USB-Uart subschematic. WIP
    USB-Uart will be bus powered. Buffer between FTDI and FPGA is missing.
    [10G_clock.sch, Levelshifters.sch, SFP_plus.sch, TLK10031.sch, TLK10031_Power.sch, cam_conn.sch, ddr.sch, gpio.sch]
2018-11-18 Finished USB Uart.
    Also a few more fabrication Informations
    [10G_clock.sch, Levelshifters.sch, SFP_plus.sch, TLK10031.sch, TLK10031_Power.sch, cam_conn.sch, ddr.sch, gpio.sch]
2018-11-18 Added decoupling Caps for TLK
    [10G_clock.sch, TLK10031.sch, TLK10031_Power.sch, pmic.sch, triggerbus.sch, zynq_MGT.sch, zynq_board.sch, zynq_config.sch]
2018-11-18 Added LDO for Triggerbus.
    [triggerbus.sch]
2018-11-18 Don't use Global Labels in the DDR Schematic
    [ddr.sch]
2018-11-18 Added LVDS Clocks, an second Reference Clock and 3 GPIOs for the IMUs.
    I also tried to beautify the Schematic a little bit.
    [Levelshifters.sch, cam_conn.sch, zynq_board.sch, zynq_pl_13.sch, zynq_pl_34.sch, zynq_pl_35.sch]
2018-11-18 Added ESD Protection for microSD Card Slot.
    Also added Fabrication Information to SD-Card Parts and a few Datasheets.
    [10G_clock.sch, Levelshifters.sch, SFP_plus.sch, TLK10031.sch, TLK10031_Power.sch, cam_conn.sch, ddr.sch, gpio.sch]
2018-11-18 Added 2 kbit i2c eeprom connected to ps.
    [10G_clock.sch, Levelshifters.sch, SFP_plus.sch, TLK10031.sch, TLK10031_Power.sch, cam_conn.sch, ddr.sch, gpio.sch]
2018-11-18 Connect MGT Supplies, POR_B, change reset button, add missing dcm files
    [10G_clock.sch, Levelshifters.sch, SFP_plus.sch, TLK10031.sch, TLK10031_Power.sch, cam_conn.sch, ddr.sch, gpio.sch]
2018-11-18 Added a first Version of footprints.
    Some of them are made using the 'kicad footprint generator'-scripting libary. Source code of them is currently not in this repository.
    [10G_clock.sch, Levelshifters.sch, SFP_plus.sch, TLK10031.sch, TLK10031_Power.sch, cam_conn.sch, ddr.sch, gpio.sch]
2018-11-18 Changed Camera Connector to be more compatible with the old one. Changing the old Board should now be not a lot of work.
    [10G_clock.sch, Levelshifters.sch, SFP_plus.sch, TLK10031.sch, TLK10031_Power.sch, cam_conn.sch, ddr.sch, gpio.sch]
2018-11-18 Connected the Configuration Bank(0).
    [zynq_config.sch, zynq_power.sch]
2018-11-18 Added a few Todos.
    [TLK10031.sch, gpio.sch, pmic.sch, triggerbus.sch, zynq_pl_13.sch, zynq_pl_34.sch, zynq_pl_35.sch]
2018-11-18 Added decoupling Capacitors for the Zynq. Also added the 2,5 V Power supply.
    The 2,5 V supply was implemented as LDO and is sourced by the 3,3 V Line.
    [TLK10031_Power.sch, ddr.sch, pmic.sch, triggerbus.sch, zynq_config.sch, zynq_pl_13.sch, zynq_pl_34.sch, zynq_pl_35.sch]
2018-11-18 Drew Triggerbus Connector Footprint and Symbol.
    [10G_clock.sch, Levelshifters.sch, SFP_plus.sch, TLK10031.sch, TLK10031_Power.sch, cam_conn.sch, ddr.sch, gpio.sch]
2018-11-18 SD Card Connector Hinge.
    [10G_clock.sch, Levelshifters.sch, SFP_plus.sch, TLK10031.sch, TLK10031_Power.sch, cam_conn.sch, ddr.sch, gpio.sch]
2018-11-18 Added Symbol and footprint for lsf0102, added footprint for USB TVS Diode.
2018-11-18 Removed all BSS138PS Transistors due actual unavailability.
    Used lsf0102 as Levelshifter for I2C bus, connected LEDs to already existing Levelshifters.
    [10G_clock.sch, Levelshifters.sch, SFP_plus.sch, TLK10031.sch, TLK10031_Power.sch, cam_conn.sch, ddr.sch, gpio.sch]
2018-11-18 First version of Power Input.
    [10G_clock.sch, Levelshifters.sch, SFP_plus.sch, TLK10031.sch, TLK10031_Power.sch, cam_conn.sch, ddr.sch, gpio.sch]
2018-11-18 Enhanced Power Connector and Filtering.
    Also added a few more production informations.
    [Levelshifters.sch, TLK10031_Power.sch, ddr.sch, pwr_con_fuse_filter.sch, usb.sch, zynq_board.sch, zynq_power.sch, zynq_ps.sch]
2018-11-18 Started to route DDR3 Memory.
    At first added missing Footprint for Reference- and Terminationvoltage Regulator. Added Powerplanes for GND and VCCO. Added decoupling Network to both DDR3 Memory Chips. There are more small caps, to support Memory from other Manufactors.
    [10G_clock.sch, DDR Traces.ods, Levelshifters.sch, SFP_plus.sch, TLK10031.sch, TLK10031_Power.sch, cam_conn.sch, ddr.sch]
2018-11-18 Corrected two mistakes in the DDR Sheet. Changed bit sequence a bit to ease routing. Added more decoupling Caps Termination Voltage.
    Mistakes: the Bank Address was not terminated. The Reset Line was connected like it's an terminated Signal. Reset should be connected through an PD Resistor to GND.
    [10G_clock.sch, DDR Traces.ods, Levelshifters.sch, TLK10031.sch, TLK10031_Power.sch, cam_conn.sch, ddr.sch, gpio.sch]
2018-11-18 Routed DDR3 Memory. Not length matched yet. Also V_TT and V_Ref is WIP. Changed Footprint for FPGA to match more Xilinx' Specs(and to ease routing).
    [zynq_board.kicad_pcb]
2018-11-18 Connected V_TT and V_Ref. Needs to be connected to 5V.
    DDR Traces are still not length matched. V_DDR supply is missing.
    [ddr.sch, zynq_board.kicad_pcb]
2018-11-18 DDR3 Addressbus is length matched.
    Databus is not length matched yet. Also DQS3 still needs to be connected. I have no good Idea for that, yet.
    [DDR Traces.ods, zynq_board.kicad_pcb]
2018-11-18 Length matched DDR3 Traces.
    TODO: evtl. GND Stiching, DDR3 Power, diff. Lane Skew correction.
    [DDR Traces.ods, zynq_board.kicad_pcb]
2018-11-18 Moved the bigger ICs and Connectors to the board to think about placing the connectors.
    [zynq_board.kicad_pcb]
2018-11-18 Added Power/Protection Circuit
    [10G_clock.sch, Levelshifters.sch, SFP_plus.sch, TLK10031.sch, TLK10031_Power.sch, cam_conn.sch, ddr.sch, gpio.sch]
2018-11-18 Length matched DDR3 Memory again.
    Forgot to keep enough space between the traces and between the meander waves.
    Also, I switched to Kicad 5.0 RC2.
    Swaped a few ddr signals.
    [10G_clock.sch, DDR Traces.ods, Levelshifters.sch, SFP_plus.sch, TLK10031.sch, TLK10031_Power.sch, _saved_ddr.sch, cam_conn.sch]
2018-11-18 Layouted most of the Power Circuit and Triggerbus Levelshifters.
    Added Footprint for Tantal Caps. Modified Footprint for MDR20 Connector, SD-Card.
    Fixed Symbol and Circuit for Power Supervisor/Delay IC.
    Also fixed some smaller things in the schematics.
    [SFP_plus.sch, TLK10031.sch, TLK10031_Power.sch, _saved_ddr.sch, pmic.sch, pwr_con_fuse_filter.sch, triggerbus.sch, usb_uart.sch]
2018-11-18 Layouted USB-UART.
    Also moved USB-OTG to the right Side of the Board. To get there
    some free Space, i moved the DDR3/Memory and the FPGA a few
    Millimeters down.
    [10G_clock.sch, DDR Traces.ods, Levelshifters.sch, SFP_plus.sch, TLK10031.sch, ddr.sch, gpio.sch, pwr_con_fuse_filter.sch]
2018-11-18 Improved Powerdistribution Network of the FPGA.
    Also started to layout USB.
    [10G_clock.sch, Levelshifters.sch, SFP_plus.sch, TLK10031.sch, TLK10031_Power.sch, ddr.sch, pmic.sch, usb.sch]
2018-11-18 Fixed Schematic Symbols
    [10G_clock.sch, Levelshifters.sch, SFP_plus.sch, TLK10031.sch, TLK10031_Power.sch, cam_conn.sch, ddr.sch, gpio.sch]
2018-11-18 WIP: TLK Powerdistribution
    [10G_clock.sch, Levelshifters.sch, SFP_plus.sch, TLK10031.sch, TLK10031_Power.sch, cam_conn.sch, ddr.sch, gpio.sch]
2018-11-18 Xaui lanes
    [TLK10031.sch, TLK10031_Power.sch, triggerbus.sch, zynq_MGT.sch]
2018-11-18 SFP+ Power Filter, Levelshifter and MGT/TLK Clock Distribution.
    [10G_clock.sch, Levelshifters.sch, SFP_plus.sch, TLK10031.sch, cam_conn.sch, ddr.sch, pmic.sch, triggerbus.sch]
2018-11-18 PS Clock, Reset Button, Cam Levelshifters and big 1.0 V Cap placed.
    Improved some Footprints and library Symbols.
    Also though about Chassis Ground.
    [10G_clock.sch, SFP_plus.sch, gpio.sch, triggerbus.sch, zynq_pl_13.sch, zynq_pl_35.sch, zynq_power.sch]
2018-11-18 WIP: route GPIOs/Levelshifters
    [Levelshifters.sch, zynq_pl_34.sch, zynq_pl_35.sch, zynq_ps.sch]
2018-11-18 WIP: routing the HF Part of the Camera Connector. I have to move the clock away from the left border.
    TODO: Fix DDR3 RAM.
    [10G_clock.sch, DDR Traces.ods, Levelshifters.sch, SFP_plus.sch, TLK10031.sch, TLK10031_Power.sch, cam_conn.sch, pmic.sch]
2018-11-18 Routed a first Version of the High Speed Part of the Camera Connector. The optional LVDS Clocks are left unconnected. I couldn't keep the Connectors Pin Assignment because it was just impossible to r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
    WIP: general Routing
    Fixed: DDR3 Trace Length Matching
    [10G_clock.sch, DDR Traces.ods, Levelshifters.sch, SFP_plus.sch, TLK10031_Power.sch, cam_conn.sch, gpio.sch, pwr_con_fuse_filter.sch]
2018-11-18 Added Courtyard to selfmade Footprints. Also general Routing WIP.
    [10G_clock.sch, Levelshifters.sch, SFP_plus.sch, TLK10031.sch, TLK10031_Power.sch, cam_conn.sch, ddr.sch, gpio.sch]
2018-11-18 WIP: general Routing
    [10G_clock.sch, Levelshifters.sch, TLK10031.sch, gpio.sch, pwr_con_fuse_filter.sch, usb_uart.sch, zynq_board.sch, zynq_pl_34.sch]
2018-11-18 Routed extra GPIO Solder Pads, reannotated the whole schematic to make it consistent.
    Power Distribution routing WIP
    [10G_clock.sch, Levelshifters.sch, SFP_plus.sch, TLK10031.sch, TLK10031_Power.sch, cam_conn.sch, ddr.sch, gpio.sch]
2018-11-18 general routing mainly power distribution, fixed some footprints
    [10G_clock.sch, TLK10031.sch, cam_conn.sch, pmic.sch, pwr_con_fuse_filter.sch, triggerbus.sch, usb_uart.sch, zynq_MGT.sch]
2018-11-18 WIP: general routing.
    I got the advice to use at least 125 µm isolation between copper layers in the stackup. This will create the need to change the top/bottom impedance matched traces. This is a TODO
    [DDR Traces.ods, pmic.sch, usb.sch]
2018-11-18 First Version without any Net not routed.
    [Levelshifters.sch, TLK10031.sch, TLK10031_Power.sch, ddr.sch, gpio.sch, pmic.sch, pwr_con_fuse_filter.sch, triggerbus.sch]
2018-11-18 Beautified Silkscreen
    [SFP_plus.sch, gpio.sch]
2019-05-30 Add sym-lib-table and fp-lib-table, fixes for KiCad 5
    [TLK10031.sch, ddr.sch, pmic.sch, triggerbus.sch]
2019-05-31 Added Step Models, fixed some footprints(e.g. added solderpaste), cleaned up a bit
    [10G_clock.sch, Levelshifters.sch, SFP_plus.sch, TLK10031.sch, TLK10031_Power.sch, cam_conn.sch, ddr.sch, gpio.sch]
